ansemjo/bubbledisp/hardware/README.txt

The schematic and PCB were created online in EasyEDA. Therefore
the directory export/ contains the JSON sources that can be imported
in an EasyEDA project.

Exported schematic, PCB layers and Gerber files are provided separately.

The bug icon on the PCB silkscreen is made by Freepik on www.flaticon.com.
https://www.flaticon.com/authors/freepik
