ansemjo/bubbledisp/hardware/bom.csv

ID | Name | Designator | Footprint | Quantity | Manufacturer Part | Manufacturer | Supplier | Supplier Part | LCSC Assembly | EasyEDA
1 | ATMEGA328PB-AUR | U1 | TQFP-32_L7.0-W7.0-P0.80-LS9.0-BL | 1 | ATMEGA328PB-AUR | Microchip Tech | LCSC | C461612
2 | 680 | R1,R2,R3,R4,R5,R6,R7,R8 | R0805 | 8 | RC0805FR-07680RL | YAGEO | LCSC | C114549
3 | 2.2K | R10,R11 | R0805 | 2 | RC0805FR-072K2L | YAGEO | LCSC | C114561
4 | 100nF | C1,C2 | C0805 | 2 | CL21B104JBCNNNC | SAMSUNG | LCSC | C62912 | Yes
5 | HP QDSP-6061 | P1 | DIP-14_L20.0-W7.6-P2.54-LS8.0-BL | 1 |  | EasyEDA | EasyEDA | E36191 |  | E36191
6 | Header-Male-2.54_1x4 | H2 | HDR-TH_4P-P2.54-V | 1 | 210S-1*4P L=11.6MMGold-plated black | Ckmtw | LCSC | C124378
7 | SW-AYZ0103AGRLC | SW1 | SW-SMD-AYZ0103AGRLC | 1 | AYZ0103AGRLC | C&K Components | Element14 | 2319972
8 | Pad | PB0,PB1,PB2 | PAD | 3
9 | ISP-PAD | ICSP | ISP-HEADER PADS 2X3 2.54 | 1
10 | 10K | R9 | R0805 | 1 | RC0805FR-0710KL | YAGEO | LCSC | C84376
