ansemjo/bubbledisp/hardware/schematic.pdf

## VCC

## GND

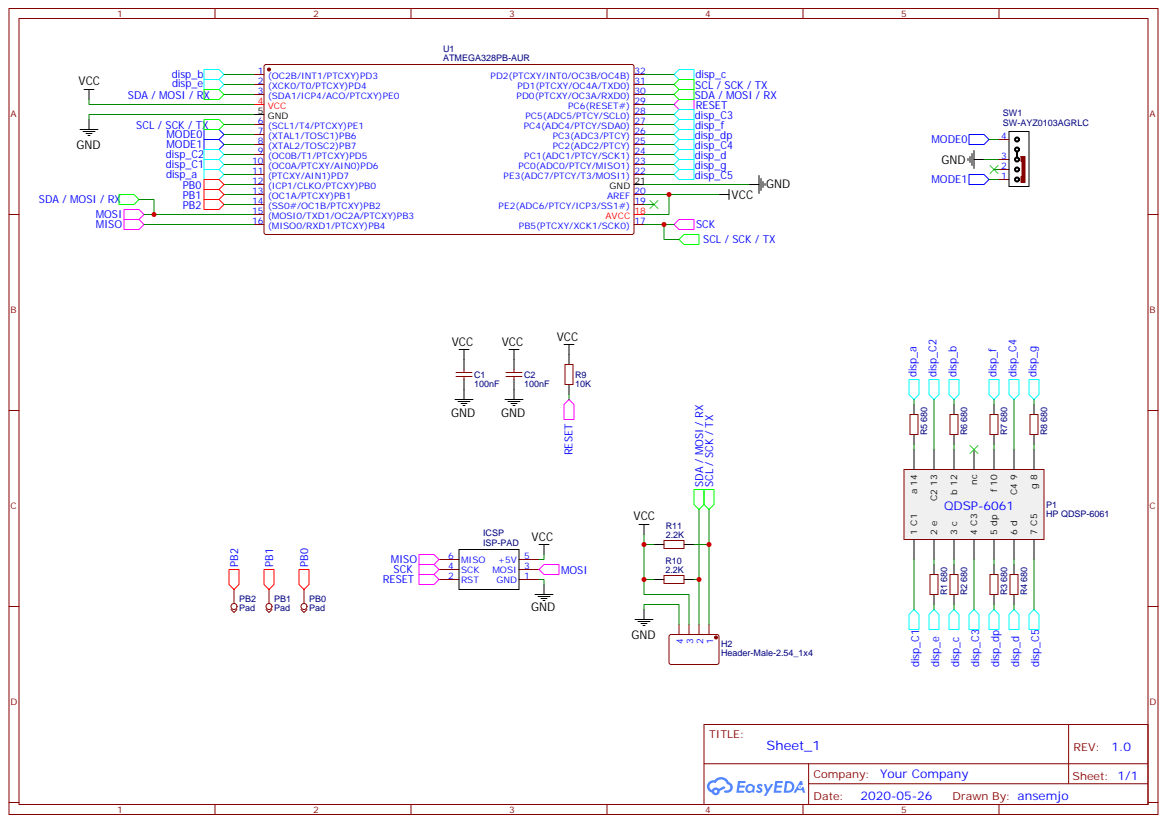
[picture p8: page 1]
