ansemjo/bubbledisp/(list of files, drawings)

Other design files:
hardware/easyeda/1-PCB_PCB_2020-05-28.json
hardware/easyeda/1-Schematic_bubbledisp.json
