ansemjo/bubbledisp/(commit log)

2020-06-27 begin tracking bubbledisp pcb in local git repository
    [1-PCB_PCB_2020-05-28.json, 1-Schematic_bubbledisp.json, bom.csv]
2020-06-27 add 'HELLO' firmware adapted from my hand-soldered bubbledisplay project
2020-06-27 add rendered pcb views from easyeda
2020-06-29 add basic i2c protocol
2020-06-29 add crude software spi implementation
